Marcos7502/SE_TP_Smartlock/Marcos Gómez Villafañe - Informe de Avance del Trabajo Final del Seminario de Sistemas Embebidos.md

 
 
 # **Smartlock**

**Autor**

**Marcos Gómez Villafañe \- Padrón 105.055**

**Fecha: 30/11/2024**

**2do cuatrimestre 2024**


<p align="center">



</p>
