Marcos7502/SE_TP_Smartlock/README_TP_FINAL.md

Se agregaron las funcionalidades de Wi-Fi a la cerradura inteligente. El video fue subido a youtube con el link: https://www.youtube.com/watch?v=X5LYxJknXuw
