Marcos7502/SE_TP_Smartlock/TP_SE_FINAL_esquematico.pdf

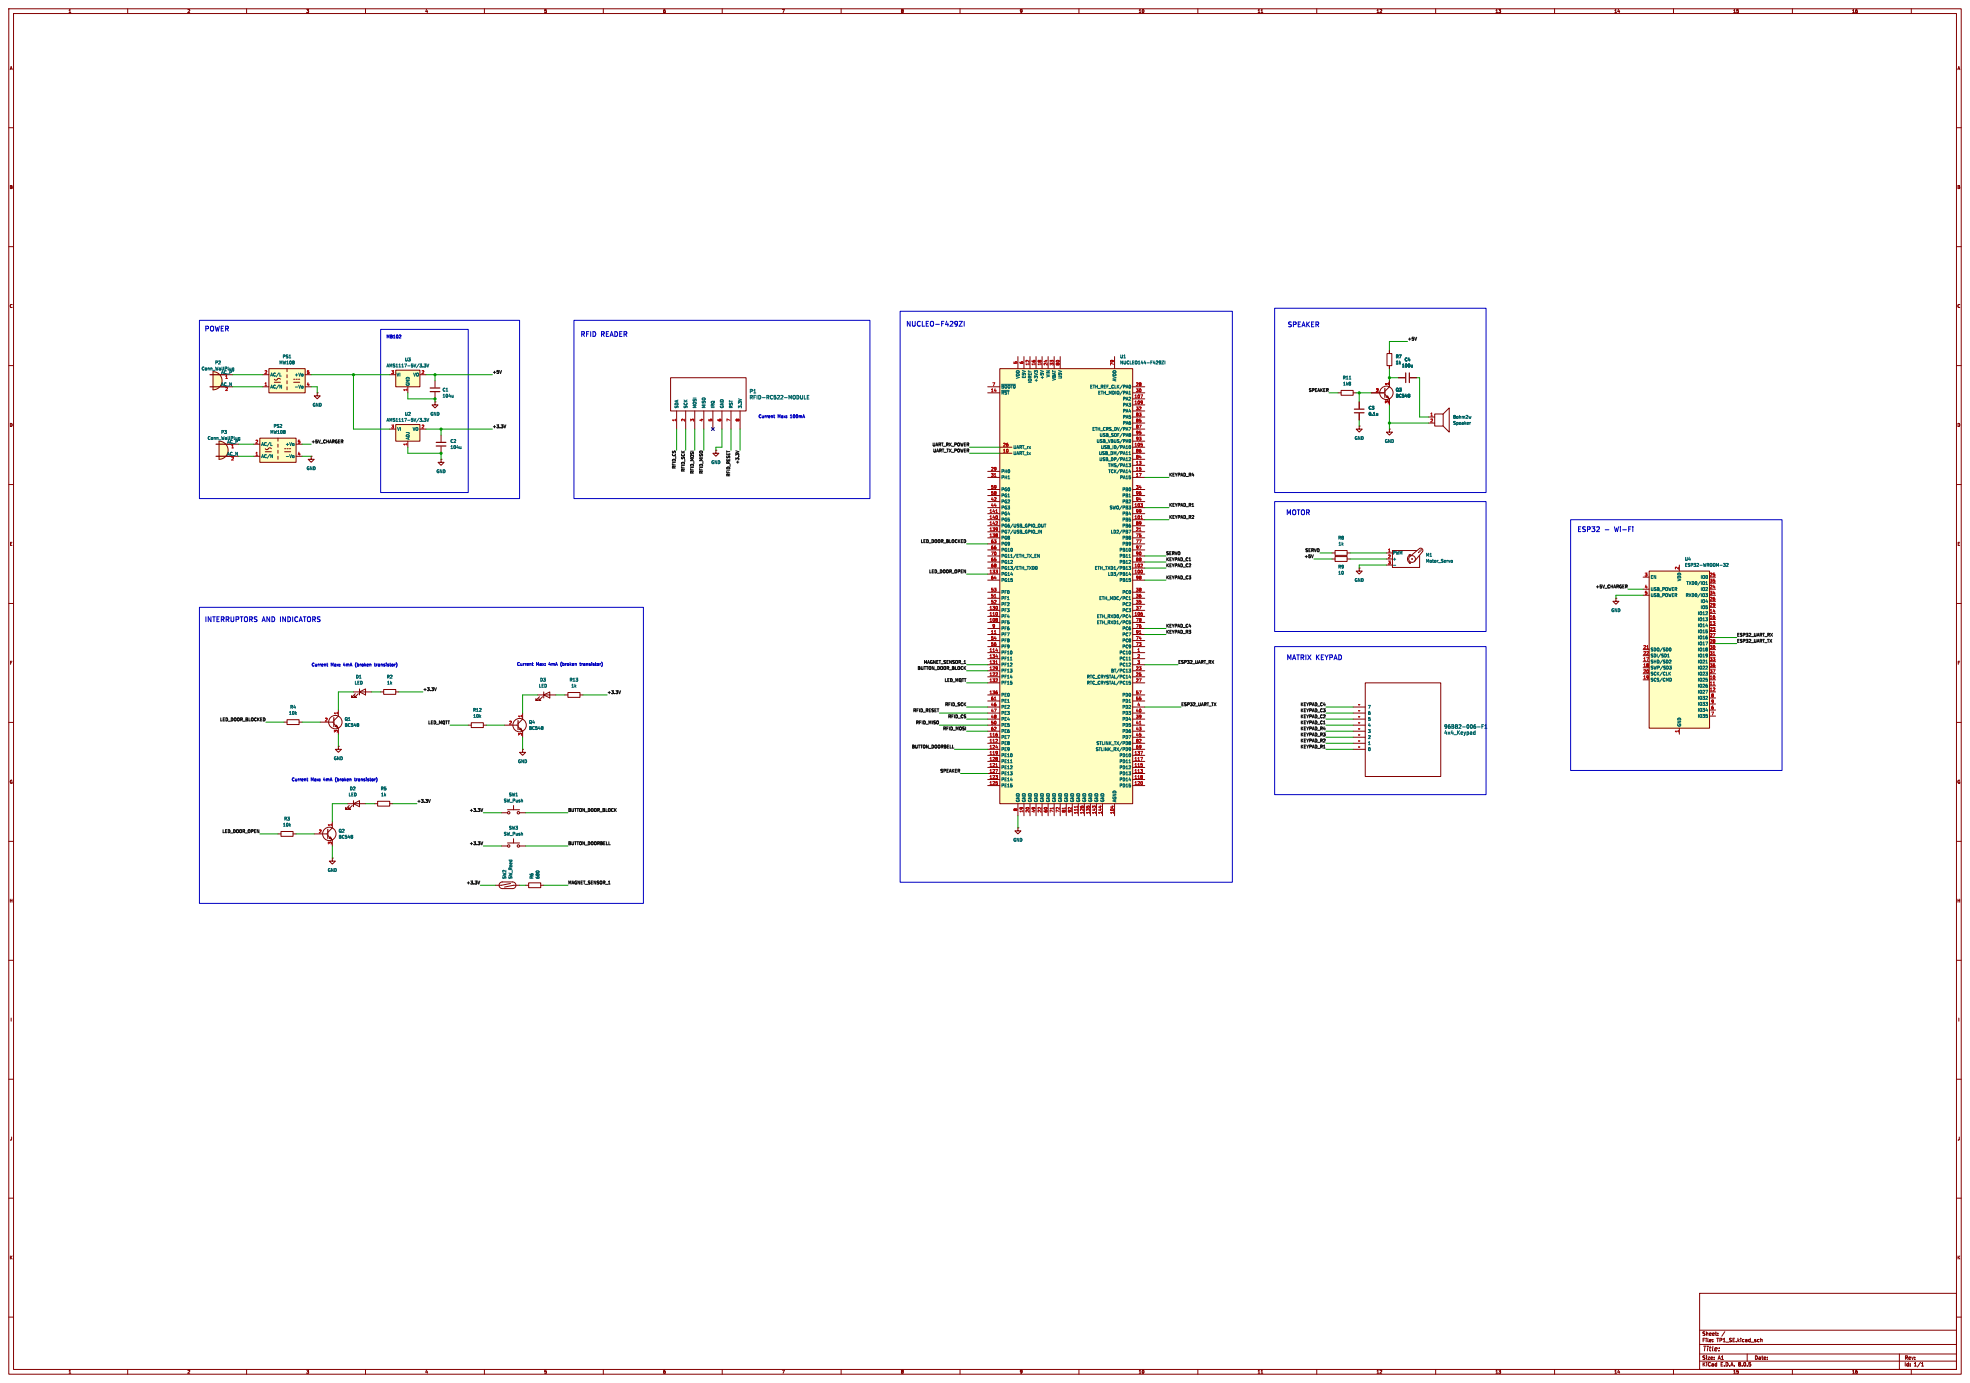
[picture p1: page 1]

Current Max: 4mA (broken transistor)
