Marcos7502/SE_TP_Smartlock/TP3_SE_esquematico.pdf

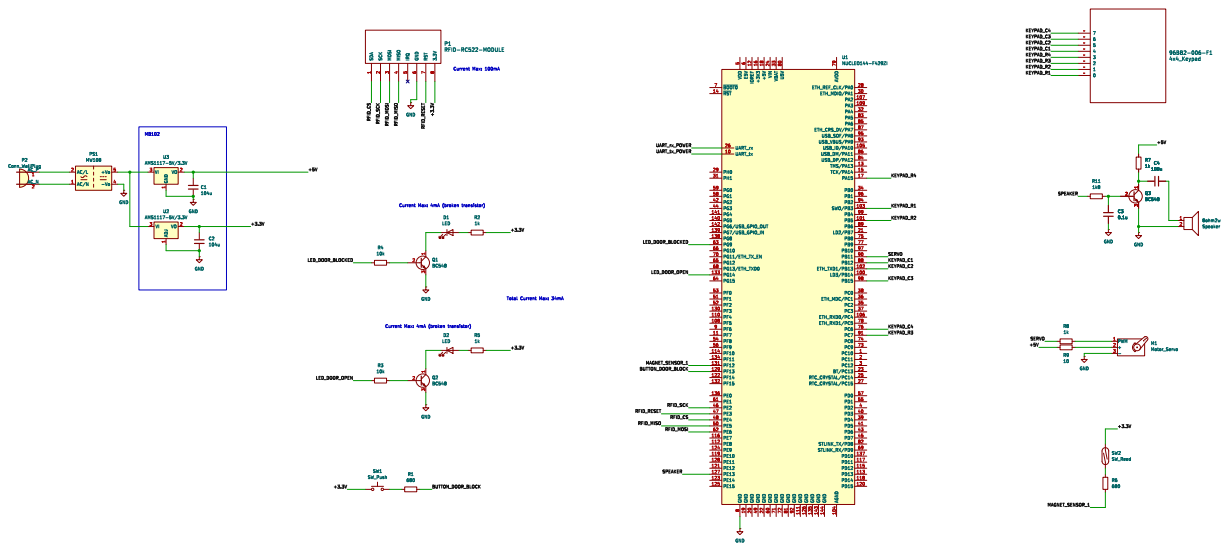
[picture p2: page 1]

2 MOSI 3 MISO
Id: 1/1 Title: File: TP1_SE.kicad_sch Sheet: / SDA

3 Q3 BC548 SW1 SW_Push ADJ 1 VO 2 VI 3 U2 AMS1117-5V/3.3V GND
