Marcos7502/SE_TP_Smartlock/TP2_SE_esquematico.pdf

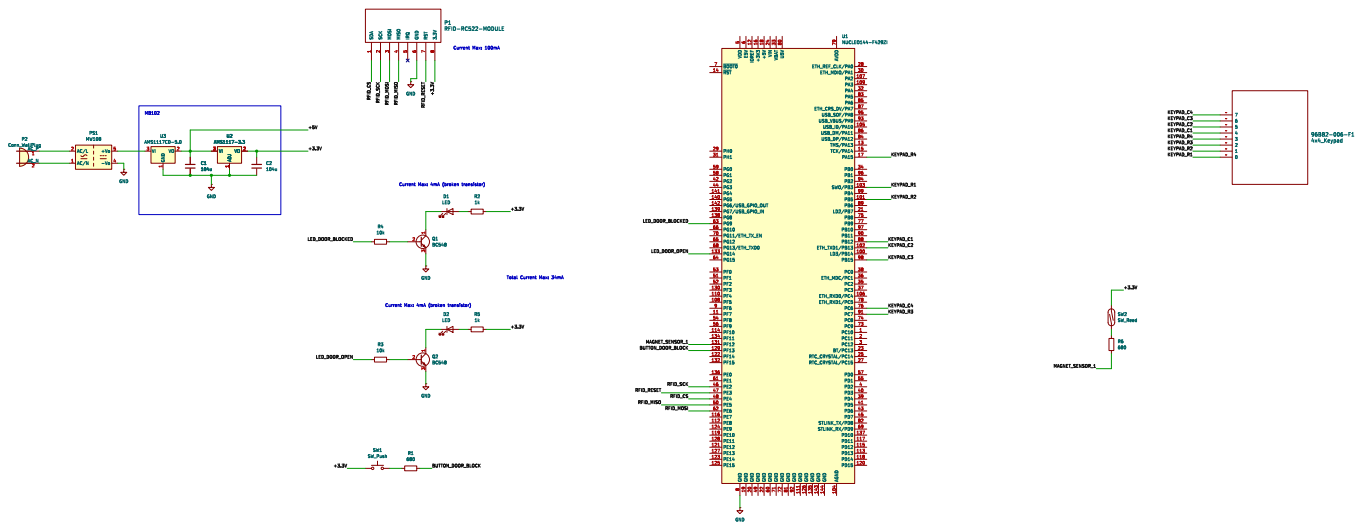
[picture p3: page 1]

Id: 1/1 Title: File: TP1_SE.kicad_sch Sheet: /
