Marcos7502/SE_TP_Smartlock/TP1_SE_esquematico.pdf

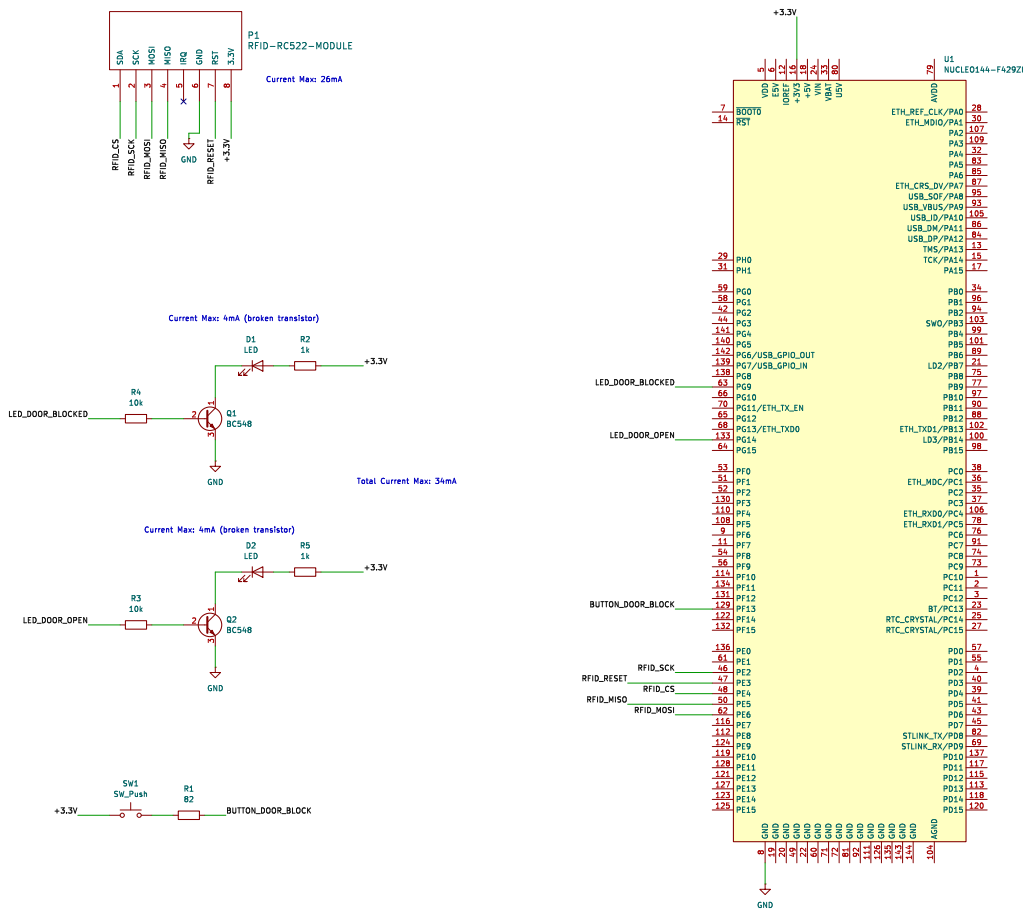
[picture p4: page 1]

+3.3V Current Max: 4mA (broken transistor) Current Max: 4mA (broken transistor)

Id: 1/1 Title: File: TP1_SE.kicad_sch Sheet: /
