Marcos7502/SE_TP_Smartlock/(commit log)

2024-08-30 Update Readme TP1
    Se describe el proyecto a hacer
2024-09-13 Update: Working led switch
2024-09-24 timer implementation debounce
2024-09-30 Timers global defines
2024-10-11 Solved multiple readings of same ID at the same time
    [global_defines.h]
2024-11-03 First Draft speaker and servo
2024-11-08 Working Code+interrupt
2024-11-18 Update Marcos Gómez Villafañe - Definición de Requisitos y Casos de Uso del Trabajo Final de 86.65 Sistemas Embebidos - Plantilla.md
2024-11-18 Rename Marcos Gómez Villafañe - Definición de Requisitos y Casos de Uso del Trabajo Final de 86.65 Sistemas Embebidos - Plantilla.md to Readme_Requisitos_y_Casos.md
2024-11-29 Update Marcos Gómez Villafañe - Informe de Avance del Trabajo Final del Seminario de Sistemas Embebidos.md
2024-12-04 First attempt to communicate uart
2024-12-08 Update Memoria del Trabajo Final del Seminario de Sistemas Embebidos - Plantilla.md
2024-12-13 Rename Memoria del Trabajo Final del Seminario de Sistemas Embebidos - Plantilla.md to Memoria del Trabajo Final del Seminario de Sistemas Embebidos.md
2024-12-13 Update Memoria del Trabajo Final del Seminario de Sistemas Embebidos.md
